sebastian-silaghi/Voltage-Stabilizer-With-Overcurrent-Protection/(list of files, drawings)

Other design files:
Simulations/SCHEMA_ELECTRICA_PROIECT_CAD.DSN
Simulations/Schema_electrica_proiect_CAD.opj
